cepdnaclk/e20-co326-HVAC-Blower-Fan-Predictive-Maintenance/Project/doc/Other_Docs/Suggested Projects.md

Industry Problems for IIoT Digital Twin
## Projects

## A. Manufacturing & Production Systems
## 1. Induction Motor Bearing Failure Detection
Detect early-stage bearing wear using vibration and current signature analysis and predict RUL.
## 2. Conveyor Belt Misalignment Monitoring
Monitor vibration asymmetry and motor current imbalance to identify belt drift.
- CNC Spindle Health Monitoring
Identify spindle imbalance and tool wear under varying RPM conditions.
## 4. Injection Moulding Machine Cycle Degradation
Detect abnormal cycle times and mechanical stress trends.
## 5. Packaging Machine Jam Prediction
Predict mechanical jams using vibration spikes and load variation.

## B. Energy & Utilities
## 6. Distribution Transformer Load & Thermal Stress Monitoring
Analyse current patterns to detect overloading and ageing trends.
## 7. Water Pump Cavitation Detection
Identify cavitation using vibration frequency signatures and current fluctuation.
## 8. Diesel Generator Predictive Maintenance

Detect combustion imbalance and mechanical degradation.
## 9. Solar Tracker Motor Failure Prediction
Monitor actuator health under varying environmental loads.
- Wind Turbine Yaw Motor Health (Scaled Model)
Detect yaw motor friction and misalignment using vibration trends.

C. Process Industry (Chemical / Food / Pharma)
## 11. Agitator Motor Imbalance Detection
Detect shaft imbalance and bearing degradation in mixing tanks.
## 12. Industrial Fan Blade Fouling Detection
Identify efficiency loss due to dust or residue accumulation.
## 13. Batch Reactor Cycle Anomaly Detection
Detect abnormal energy usage per batch.
## 14. Screw Feeder Jamming Prediction
Monitor torque and vibration to detect material blockage.
## 15. Industrial Dryer Motor Degradation
Detect airflow reduction and mechanical wear.

## D. Infrastructure & Buildings
- Elevator Motor Condition Monitoring (Scaled Model)
Detect traction motor stress and imbalance.
- HVAC Blower Fan Predictive Maintenance

Monitor airflow degradation and bearing wear.
## 18. Escalator Drive System Health
Identify abnormal load and vibration during peak usage.
## 19. Water Supply Booster Pump Monitoring
Detect leakage-induced load variations.
## 20. Building Emergency Generator Health
Predict start-failure risks using historical trends.

## E. Transportation & Logistics
## 21. Automated Warehouse Conveyor Health
Detect roller wear and belt friction changes.
- Railway Point Motor Monitoring (Simulated)
Detect actuator stiffness and electrical anomalies.
- Automated Guided Vehicle (AGV) Drive Motor Health
Monitor drive motor load and vibration.
- Port Crane Hoist Motor Monitoring (Scaled)
Detect rope tension imbalance and mechanical fatigue.
## 25. Airport Baggage Handling System Motor Monitoring
Predict jam and misalignment events.

## F. Utilities & Environmental Systems
## 26. Sewage Pump Blockage Prediction

Detect early-stage clogging through load changes.
## 27. Industrial Air Compressor Health Monitoring
Detect valve leakage and piston wear.
## 28. Cooling Tower Fan Degradation
Identify imbalance and blade damage.
## 29. Irrigation Pump Efficiency Monitoring
Detect impeller wear and suction problems.
## 30. Dust Extraction System Fan Health
Monitor clogging and airflow reduction.

## G. Specialised & Emerging Industry Use Cases
- Semiconductor Cleanroom Fan Filter Unit (FFU) Health
Detect airflow degradation and motor imbalance.
## 32. Data Centre Cooling Fan Predictive Maintenance
Predict fan failure to prevent thermal events.
## 33. Medical Facility Vacuum Pump Monitoring
Detect degradation affecting system reliability.
## 34. Food Processing Conveyor Hygiene Degradation
Detect abnormal friction due to residue buildup.
- Smart Factory Digital Twin for Energy Optimisation
Predict energy waste patterns and optimise operational states.

How These Fit the Same Framework
Each problem must implement:
● ESP32-S3 edge data acquisition

● Vibration + current sensing

● MQTT Sparkplug B with UNS

● Edge anomaly detection (TinyML)

● Cloud RUL estimation

● Digital Twin with bidirectional control

● Cybersecurity & reliability features
