cepdnaclk/e20-co326-HVAC-Blower-Fan-Predictive-Maintenance/Project/doc/Other_Docs/Implementation.md

CO326: Project Implementation

● Since you are doing the FYP, this project is designed in such a way that it will not
overload you, but you will learn the important Learning Outcomes expected of the project
● All the basic implementations will bethe  same for all groups
● Group-specific implementations should be simple but demonstrate how deeply you have
understood the principles of industrial systems. The project is not another undergraduate
project, but it should be industry-ready.
● Read the project proposal and Suggested Projects
## ○
## Project Proposal
## ○
## Suggested Projects
● Install docker
● Install the following containers
○ Grafana (SCADA / Visualisation / Digital Twin)
○ NodeRed (Flow Logic)
○ Mosquitto_Brocker (
○ InfluxDB (Hostroian)
● Develop ML application in ESP32-S3 (Edge Logic)
## ○
