cepdnaclk/e20-co326-HVAC-Blower-Fan-Predictive-Maintenance/stage1-training/data/cluster_scatter.png

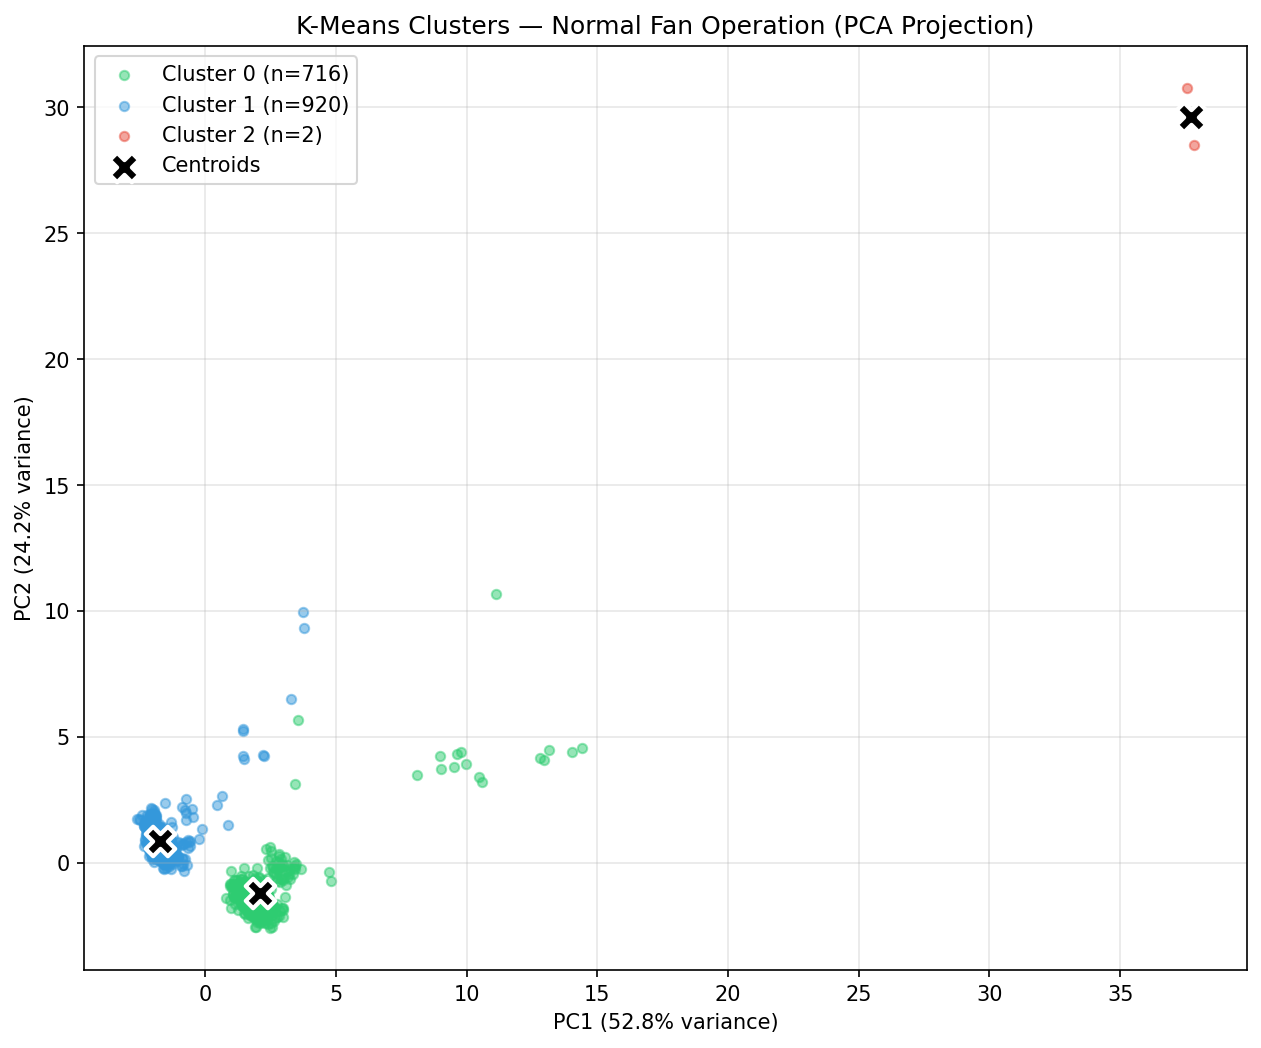
stage1-training/data/cluster_scatter.png
