cepdnaclk/e20-co326-HVAC-Blower-Fan-Predictive-Maintenance/stage1-training/data/confusion_matrix.png

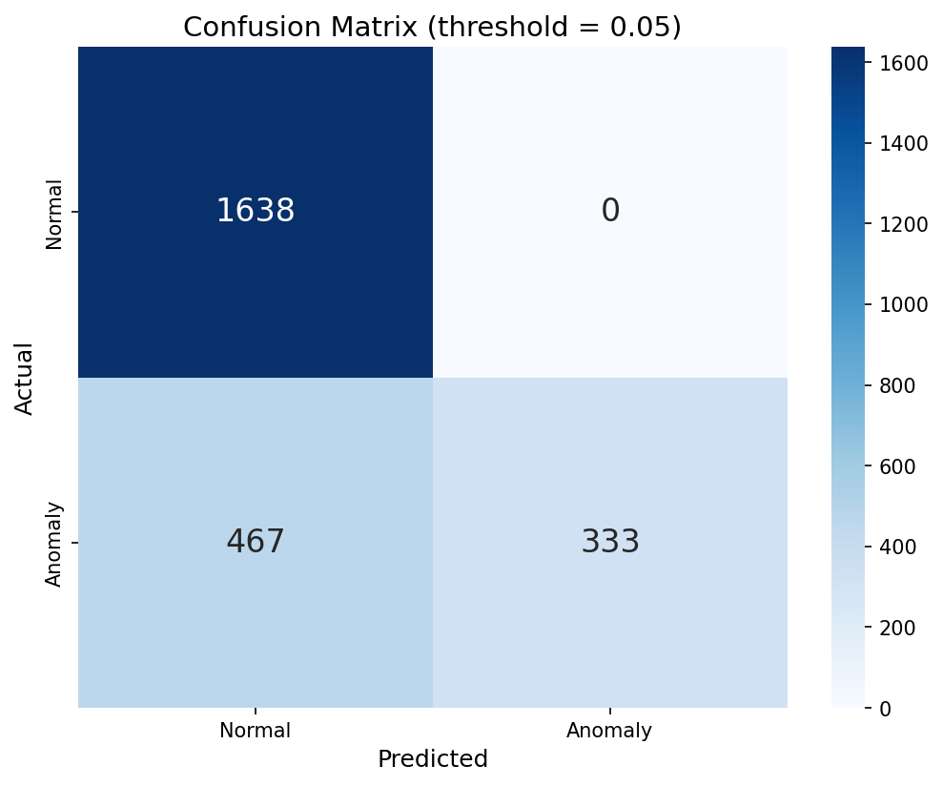
stage1-training/data/confusion_matrix.png
