cepdnaclk/e20-co326-HVAC-Blower-Fan-Predictive-Maintenance/stage1-training/data/elbow_plot.png

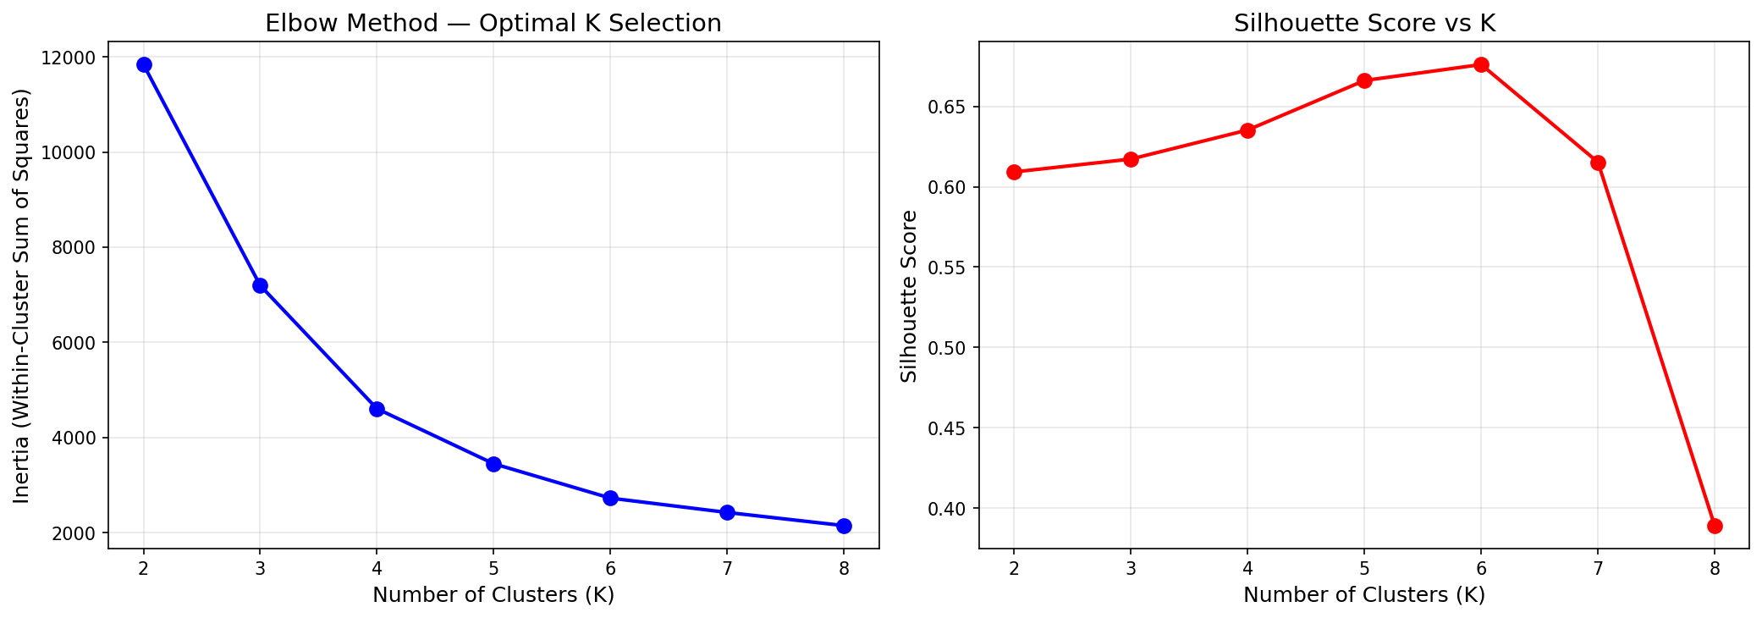
stage1-training/data/elbow_plot.png
