cepdnaclk/e20-co326-HVAC-Blower-Fan-Predictive-Maintenance/stage1-training/data/roc_curve.png

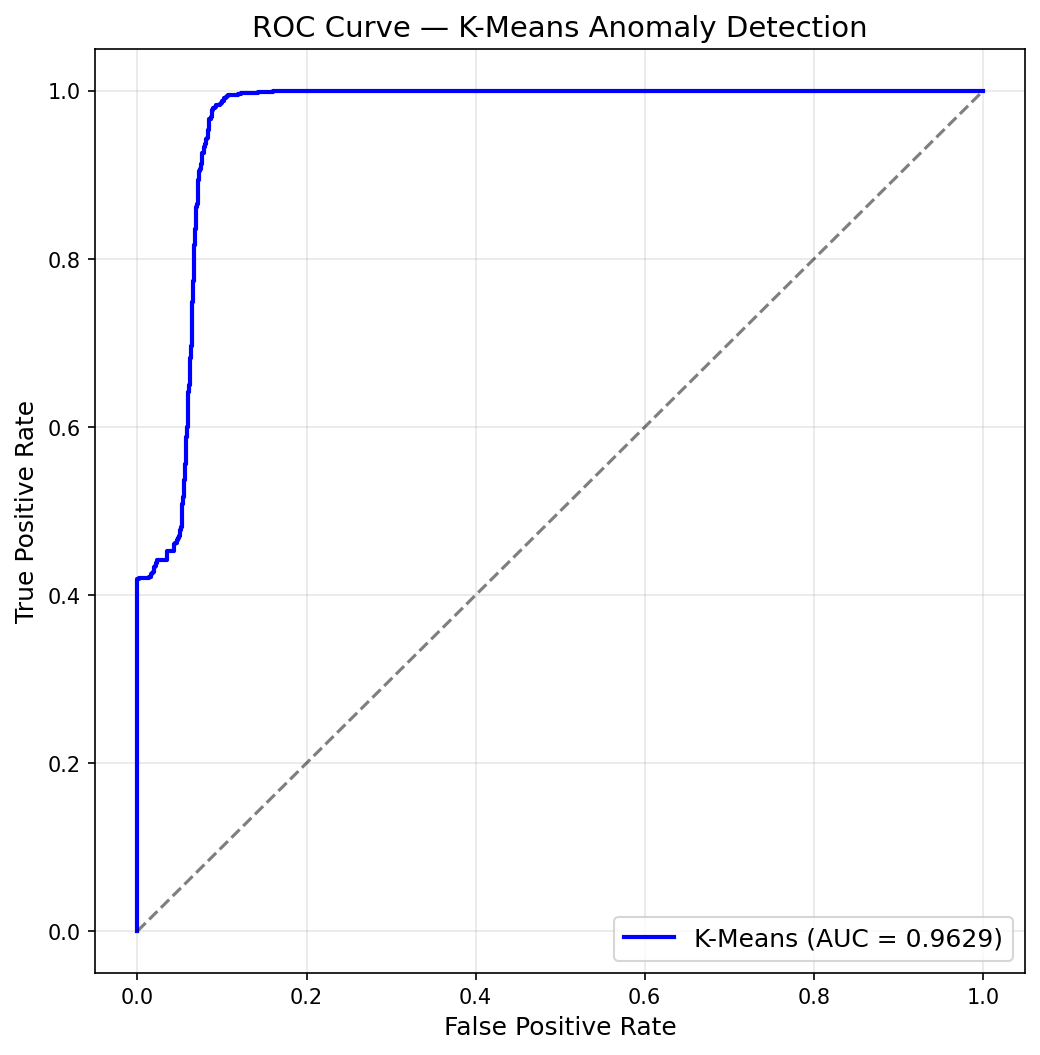
stage1-training/data/roc_curve.png
