cepdnaclk/e20-co326-HVAC-Blower-Fan-Predictive-Maintenance/stage1-training/data/score_distribution.png

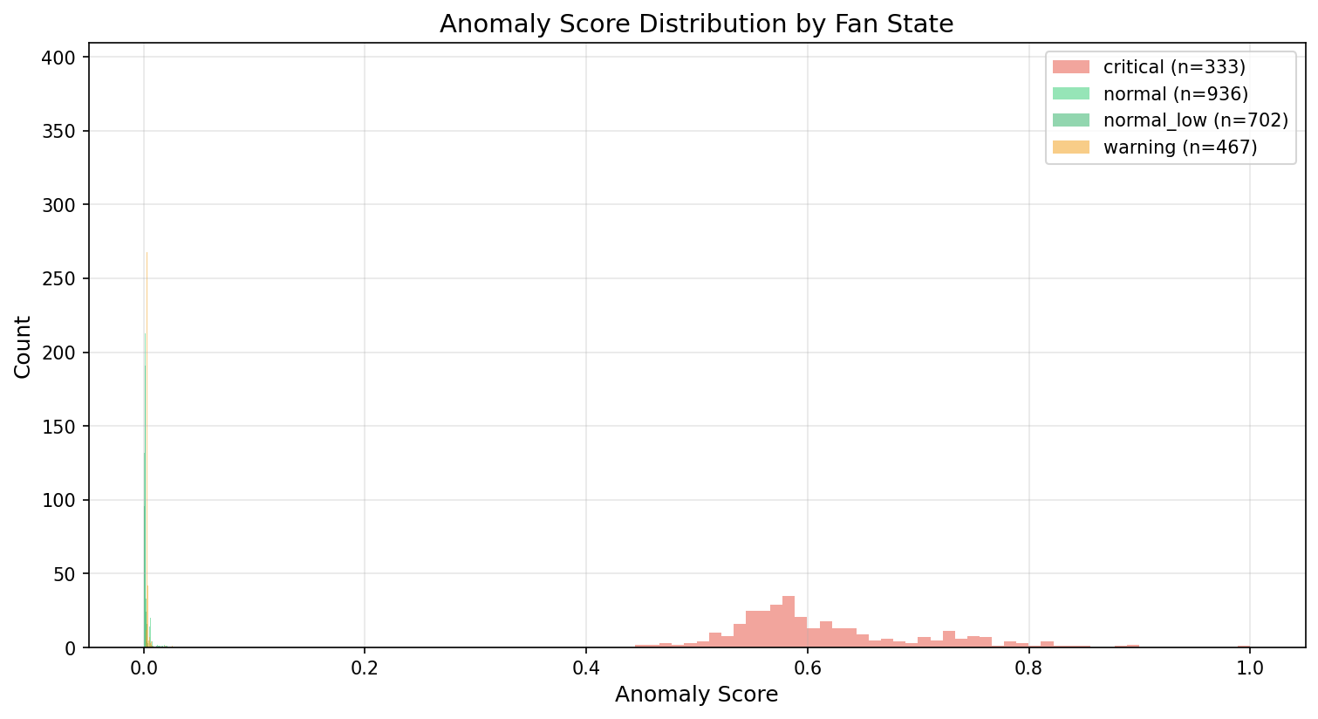
stage1-training/data/score_distribution.png
