cepdnaclk/e20-co326-HVAC-Blower-Fan-Predictive-Maintenance/stage1-training/data/ae_training_history.png

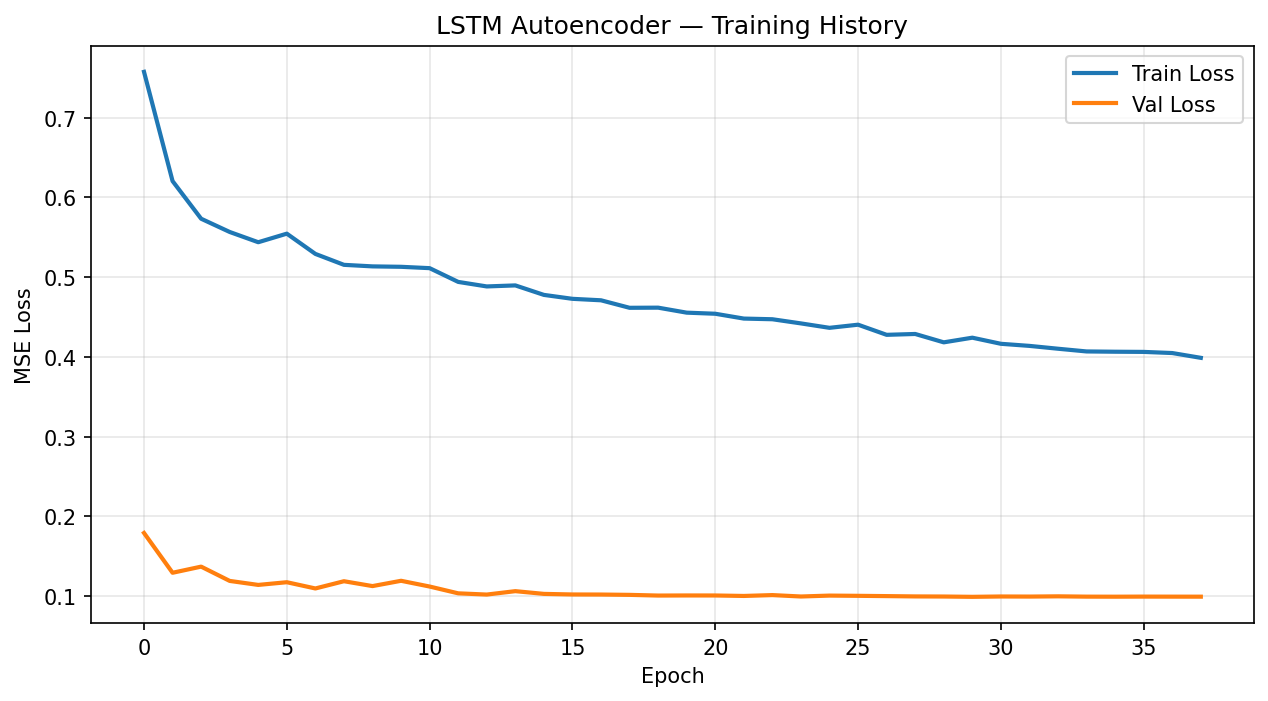
stage1-training/data/ae_training_history.png
