cepdnaclk/e20-co326-HVAC-Blower-Fan-Predictive-Maintenance/(commit log)

2026-04-20 Connect Grafana using conatiner
    finish the whole docker network using docker-compose.yml we create all the mqtt ,node-red ,infux db and grafana conatiners one custom bridge netwoek and visualize data from processed data from esp32
2026-04-20 Adding Esp32 code for Send data for Mqtt broker
    previouse stage we send data to MQTT conatiner using Cmd commands and go inside that conatiner manually and geenrate data and that data propagate through pipeline until grafana dashboard using each conatiner through by using custom bridgr network , so now i replace that initila start , by esp32 device send the data now to the mqtt conatiner my him self using my LocaL Ip and conatiner expose port number via logging to home wifi
    [sketch_apr20b.ino]
2026-04-20 feat: add training data, model artifacts, and diagnostic plots for k-means clustering
    [features_all.csv, raw_critical_20260421_005048.csv, raw_warning_20260421_002024.csv]
2026-04-30 feat(stage1): update autoencoder training script with improved architecture
2026-04-30 feat(stage1): add trained autoencoder model weights (Keras)
2026-04-30 docs(stage1): add autoencoder training history visualization
2026-04-30 docs(stage1): add confusion matrix for model evaluation
2026-04-30 docs(stage1): add ROC curve analysis for anomaly detection threshold
2026-04-30 docs(stage1): add anomaly score distribution plot
2026-04-30 feat(stage1): add calibrated threshold results for anomaly classification
2026-04-30 feat(stage1): add exported C header with model parameters for ESP32
2026-04-30 feat(stage2): add Docker Compose stack with Mosquitto, Node-RED, InfluxDB, and Grafana
2026-04-30 feat(stage2): add ESP32 inference firmware with K-Means anomaly detection and MQTT
2026-04-30 feat(stage2): add trained model parameters header for edge inference
2026-04-30 docs(stage2): add comprehensive README with wiring diagrams and demo presentation plan
2026-04-30 Dummy data generation
    [fan_fault_data.csv, fan_normal_data.csv]
